marc-cr1810/SoccBot/PCB/KiCAD/Lightsensor/Lightsensor.kicad_pcb

## KiCad design PCB/KiCAD/Lightsensor/Lightsensor.kicad_pcb (2025-05-09)

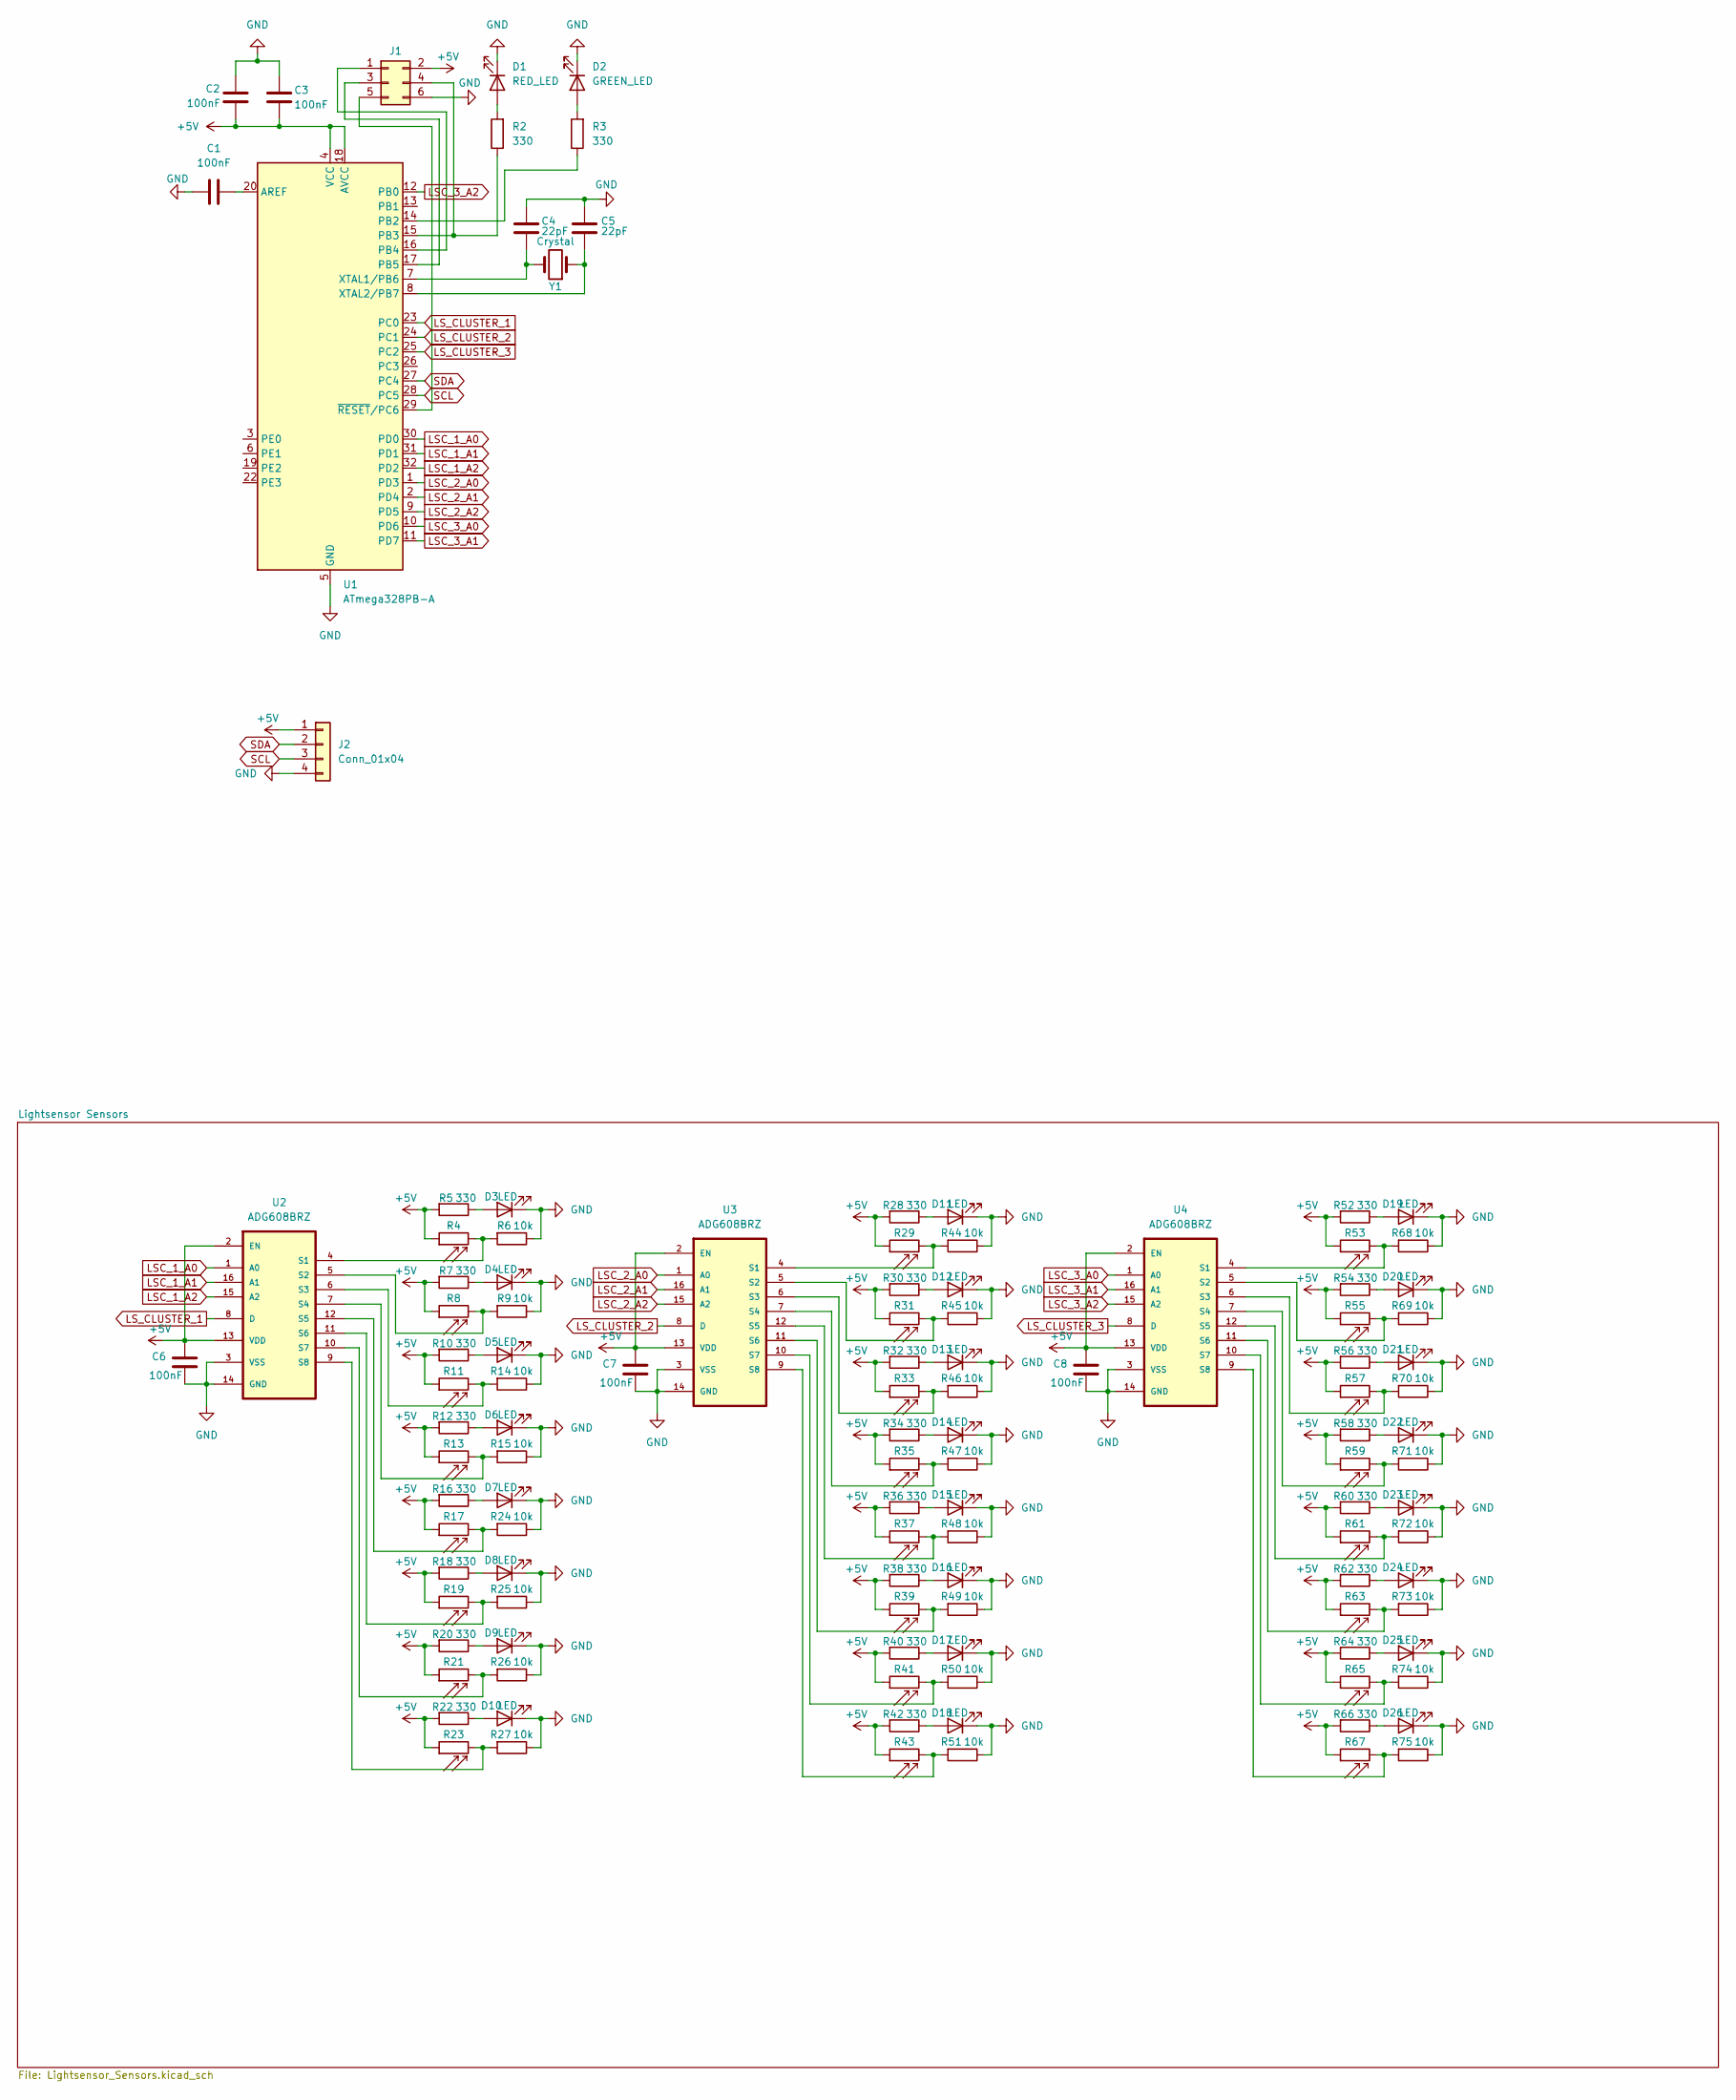
[picture p1: schematic Lightsensor.kicad_sch]

Parts:
C1, C2, C3, C6, C7, C8: 100nF; C_0805_2012Metric_Pad1.18x1.45mm_HandSolder
C4, C5: 22pF; C_0805_2012Metric_Pad1.18x1.45mm_HandSolder
D1: RED_LED; LED_0805_2012Metric_Pad1.15x1.40mm_HandSolder
D2: GREEN_LED; LED_0805_2012Metric_Pad1.15x1.40mm_HandSolder
D3, D4, D5, D6, D7, D8, D9, D10, D11, D12, D13, D14, D15, D16, D17, D18, D19, D20, D21, D22, D23, D24, D25, D26: LED; LED_SMD_3mm
J1: Conn_02x03_Odd_Even; IDC-Header_2x03_P2.54mm_Vertical_SMD
J2: Conn_01x04; JST_PH_B4B-PH-SM4-TB_1x04-1MP_P2.00mm_Vertical
R2, R3, R5, R7, R10, R12, R16, R18, R20, R22, R28, R30, R32, R34, R36, R38, R40, R42, R52, R54, R56, R58, R60, R62, R64, R66: 330; R_0805_2012Metric_Pad1.20x1.40mm_HandSolder
R4, R8, R11, R13, R17, R19, R21, R23, R29, R31, R33, R35, R37, R39, R41, R43, R53, R55, R57, R59, R61, R63, R65, R67: R_Photo; Photoresistor_SMD_5mm
R6, R9, R14, R15, R24, R25, R26, R27, R44, R45, R46, R47, R48, R49, R50, R51, R68, R69, R70, R71, R72, R73, R74, R75: 10k; R_0805_2012Metric_Pad1.20x1.40mm_HandSolder
U1: ATmega328PB-A; TQFP-32_7x7mm_P0.8mm
U2, U3, U4: ADG608BRZ; MPN ADG608BRUZ
Y1: Crystal; Crystal_SMD_HC49-SD

Connections:
+5V: C2.2, C3.2, C6.1, C7.1, C8.1, J1.2, J2.1, R4.1, R5.2, R7.2, R8.1, R10.2, R11.1, R12.2, R13.1, R16.2, R17.1, R18.2, R19.1, R20.2, R21.1, R22.2, R23.1, R28.2, R29.1, R30.2, R31.1, R32.2, R33.1, R34.2, R35.1, R36.2, R37.1, R38.2, R39.1, R40.2, R41.1, R42.2, R43.1, R52.2, R53.1, R54.2, R55.1, R56.2, R57.1, R58.2, R59.1, R60.2, R61.1, R62.2, R63.1, R64.2, R65.1, R66.2, R67.1, U1.4 (VCC), U1.18 (AVCC), U2.2 (EN), U2.13 (VDD), U3.2 (EN), U3.13 (VDD), U4.2 (EN), U4.13 (VDD)
GND: C1.2, C2.1, C3.1, C4.1, C5.1, C6.2, C7.2, C8.2, D1.1 (K), D2.1 (K), D3.1 (K), D4.1 (K), D5.1 (K), D6.1 (K), D7.1 (K), D8.1 (K), D9.1 (K), D10.1 (K), D11.1 (K), D12.1 (K), D13.1 (K), D14.1 (K), D15.1 (K), D16.1 (K), D17.1 (K), D18.1 (K), D19.1 (K), D20.1 (K), D21.1 (K), D22.1 (K), D23.1 (K), D24.1 (K), D25.1 (K), D26.1 (K), J1.6, J2.4, R6.1, R9.1, R14.1, R15.1, R24.1, R25.1, R26.1, R27.1, R44.1, R45.1, R46.1, R47.1, R48.1, R49.1, R50.1, R51.1, R68.1, R69.1, R70.1, R71.1, R72.1, R73.1, R74.1, R75.1, U1.5 (GND), U1.21 (GND), U2.3 (VSS), U2.14 (GND), U3.3 (VSS), U3.14 (GND), U4.3 (VSS), U4.14 (GND)
LSC_1_A0: U1.30 (PD0), U2.1 (A0)
LSC_1_A1: U1.31 (PD1), U2.16 (A1)
LSC_1_A2: U1.32 (PD2), U2.15 (A2)
LSC_2_A0: U1.1 (PD3), U3.1 (A0)
LSC_2_A1: U1.2 (PD4), U3.16 (A1)
LSC_2_A2: U1.9 (PD5), U3.15 (A2)
LSC_3_A0: U1.10 (PD6), U4.1 (A0)
LSC_3_A1: U1.11 (PD7), U4.16 (A1)
LSC_3_A2: U1.12 (PB0), U4.15 (A2)
LS_CLUSTER_1: U1.23 (PC0), U2.8 (D)
LS_CLUSTER_2: U1.24 (PC1), U3.8 (D)
LS_CLUSTER_3: U1.25 (PC2), U4.8 (D)
unnamed: D1.2 (A), R2.2
unnamed: D2.2 (A), R3.2
unnamed: D3.2 (A), R5.1
unnamed: D4.2 (A), R7.1
unnamed: D5.2 (A), R10.1
unnamed: D6.2 (A), R12.1
unnamed: D7.2 (A), R16.1
unnamed: D8.2 (A), R18.1
unnamed: D9.2 (A), R20.1
unnamed: D10.2 (A), R22.1
unnamed: D11.2 (A), R28.1
unnamed: D12.2 (A), R30.1
unnamed: D13.2 (A), R32.1
unnamed: D14.2 (A), R34.1
unnamed: D15.2 (A), R36.1
unnamed: D16.2 (A), R38.1
unnamed: D17.2 (A), R40.1
unnamed: D18.2 (A), R42.1
unnamed: D19.2 (A), R52.1
unnamed: D20.2 (A), R54.1
unnamed: D21.2 (A), R56.1
unnamed: D22.2 (A), R58.1
unnamed: D23.2 (A), R60.1
unnamed: D24.2 (A), R62.1
unnamed: D25.2 (A), R64.1
unnamed: D26.2 (A), R66.1
unnamed: J1.1, U1.16 (PB4)
unnamed: J1.3, U1.17 (PB5)
unnamed: J1.4, R2.1, U1.15 (PB3)
unnamed: J1.5, U1.29 (~RESET/PC6)
unnamed: C1.1, U1.20 (AREF)
unnamed: R3.1, U1.14 (PB2)
unnamed: C4.2, U1.7 (XTAL1/PB6), Y1.2
unnamed: C5.2, U1.8 (XTAL2/PB7), Y1.1
unnamed: R4.2, R6.2, U2.4 (S1)
unnamed: R8.2, R9.2, U2.5 (S2)
unnamed: R11.2, R14.2, U2.6 (S3)
unnamed: R13.2, R15.2, U2.7 (S4)
unnamed: R17.2, R24.2, U2.12 (S5)
unnamed: R19.2, R25.2, U2.11 (S6)
unnamed: R21.2, R26.2, U2.10 (S7)
unnamed: R23.2, R27.2, U2.9 (S8)
unnamed: R29.2, R44.2, U3.4 (S1)
unnamed: R31.2, R45.2, U3.5 (S2)
unnamed: R33.2, R46.2, U3.6 (S3)
unnamed: R35.2, R47.2, U3.7 (S4)
unnamed: R37.2, R48.2, U3.12 (S5)
unnamed: R39.2, R49.2, U3.11 (S6)
unnamed: R41.2, R50.2, U3.10 (S7)
unnamed: R43.2, R51.2, U3.9 (S8)
unnamed: R53.2, R68.2, U4.4 (S1)
unnamed: R55.2, R69.2, U4.5 (S2)
unnamed: R57.2, R70.2, U4.6 (S3)
unnamed: R59.2, R71.2, U4.7 (S4)
unnamed: R61.2, R72.2, U4.12 (S5)
unnamed: R63.2, R73.2, U4.11 (S6)
unnamed: R65.2, R74.2, U4.10 (S7)
unnamed: R67.2, R75.2, U4.9 (S8)
SCL: J2.3, U1.28 (PC5)
SDA: J2.2, U1.27 (PC4)

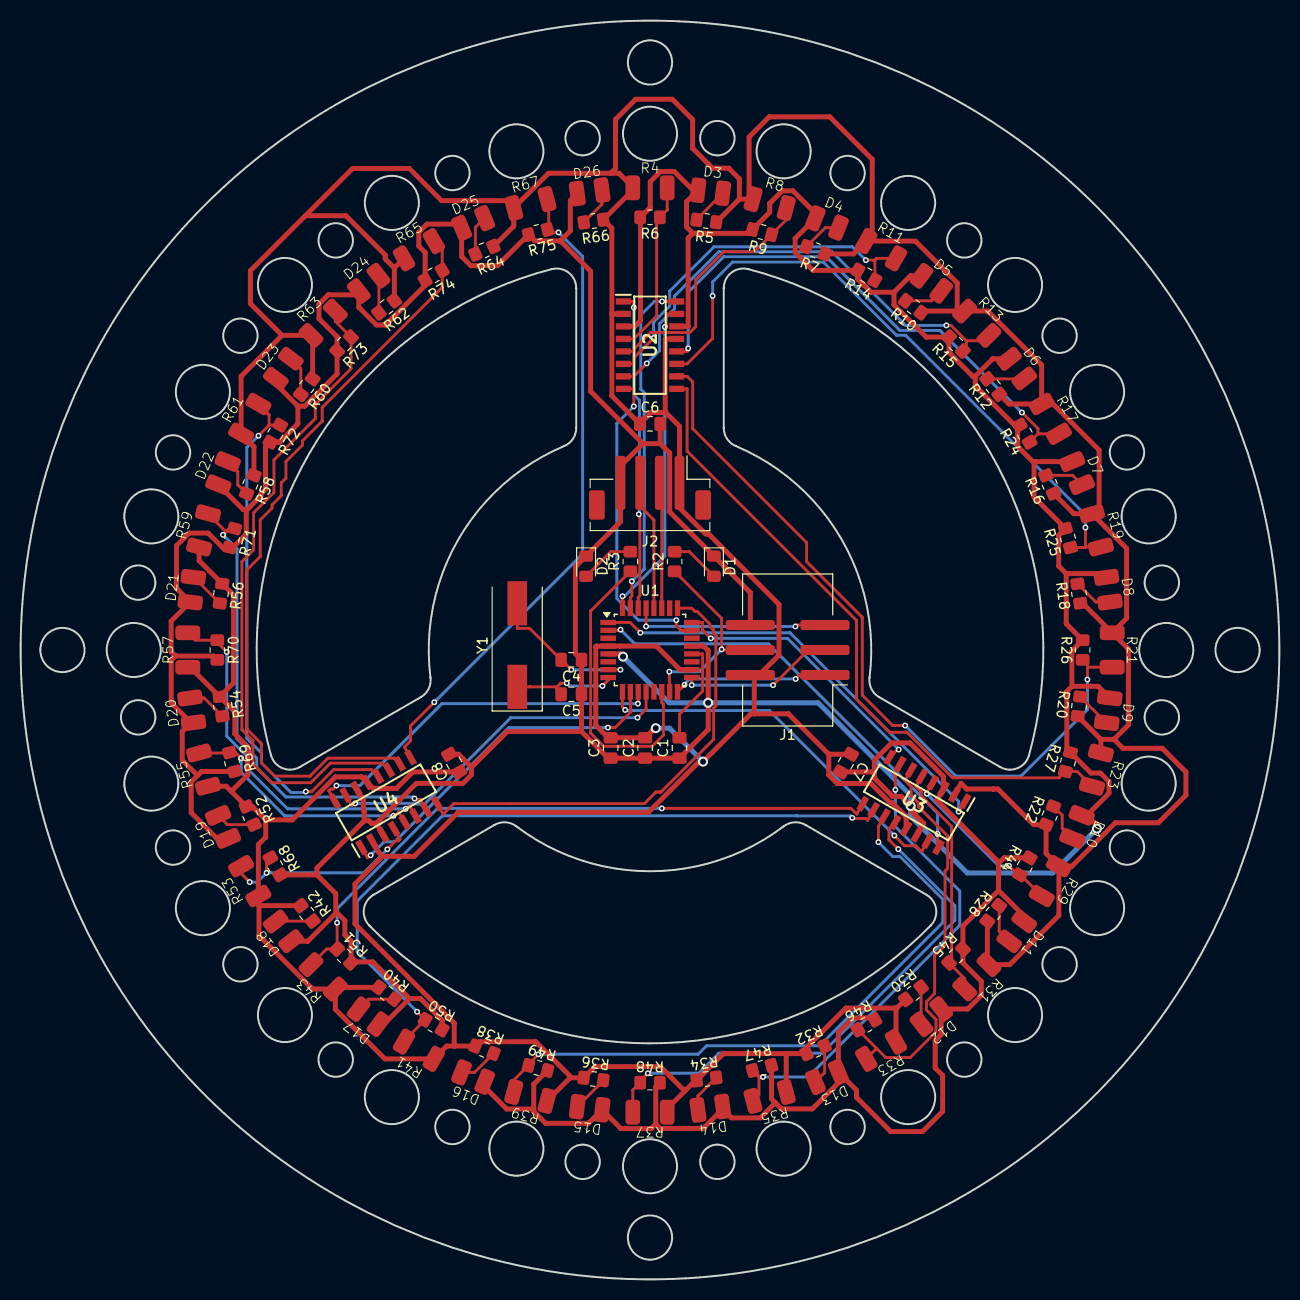
[picture p2: board Lightsensor.kicad_pcb from above]

Board: 2 copper layers, 128.0 x 128.0 mm, 115 parts (0 on the bottom side), 74 nets.
