marc-cr1810/SoccBot/PCB/KiCAD/Main (Teensy)/Main (Teensy).kicad_pcb

## KiCad design PCB/KiCAD/Main (Teensy)/Main (Teensy).kicad_pcb (2025-05-09)

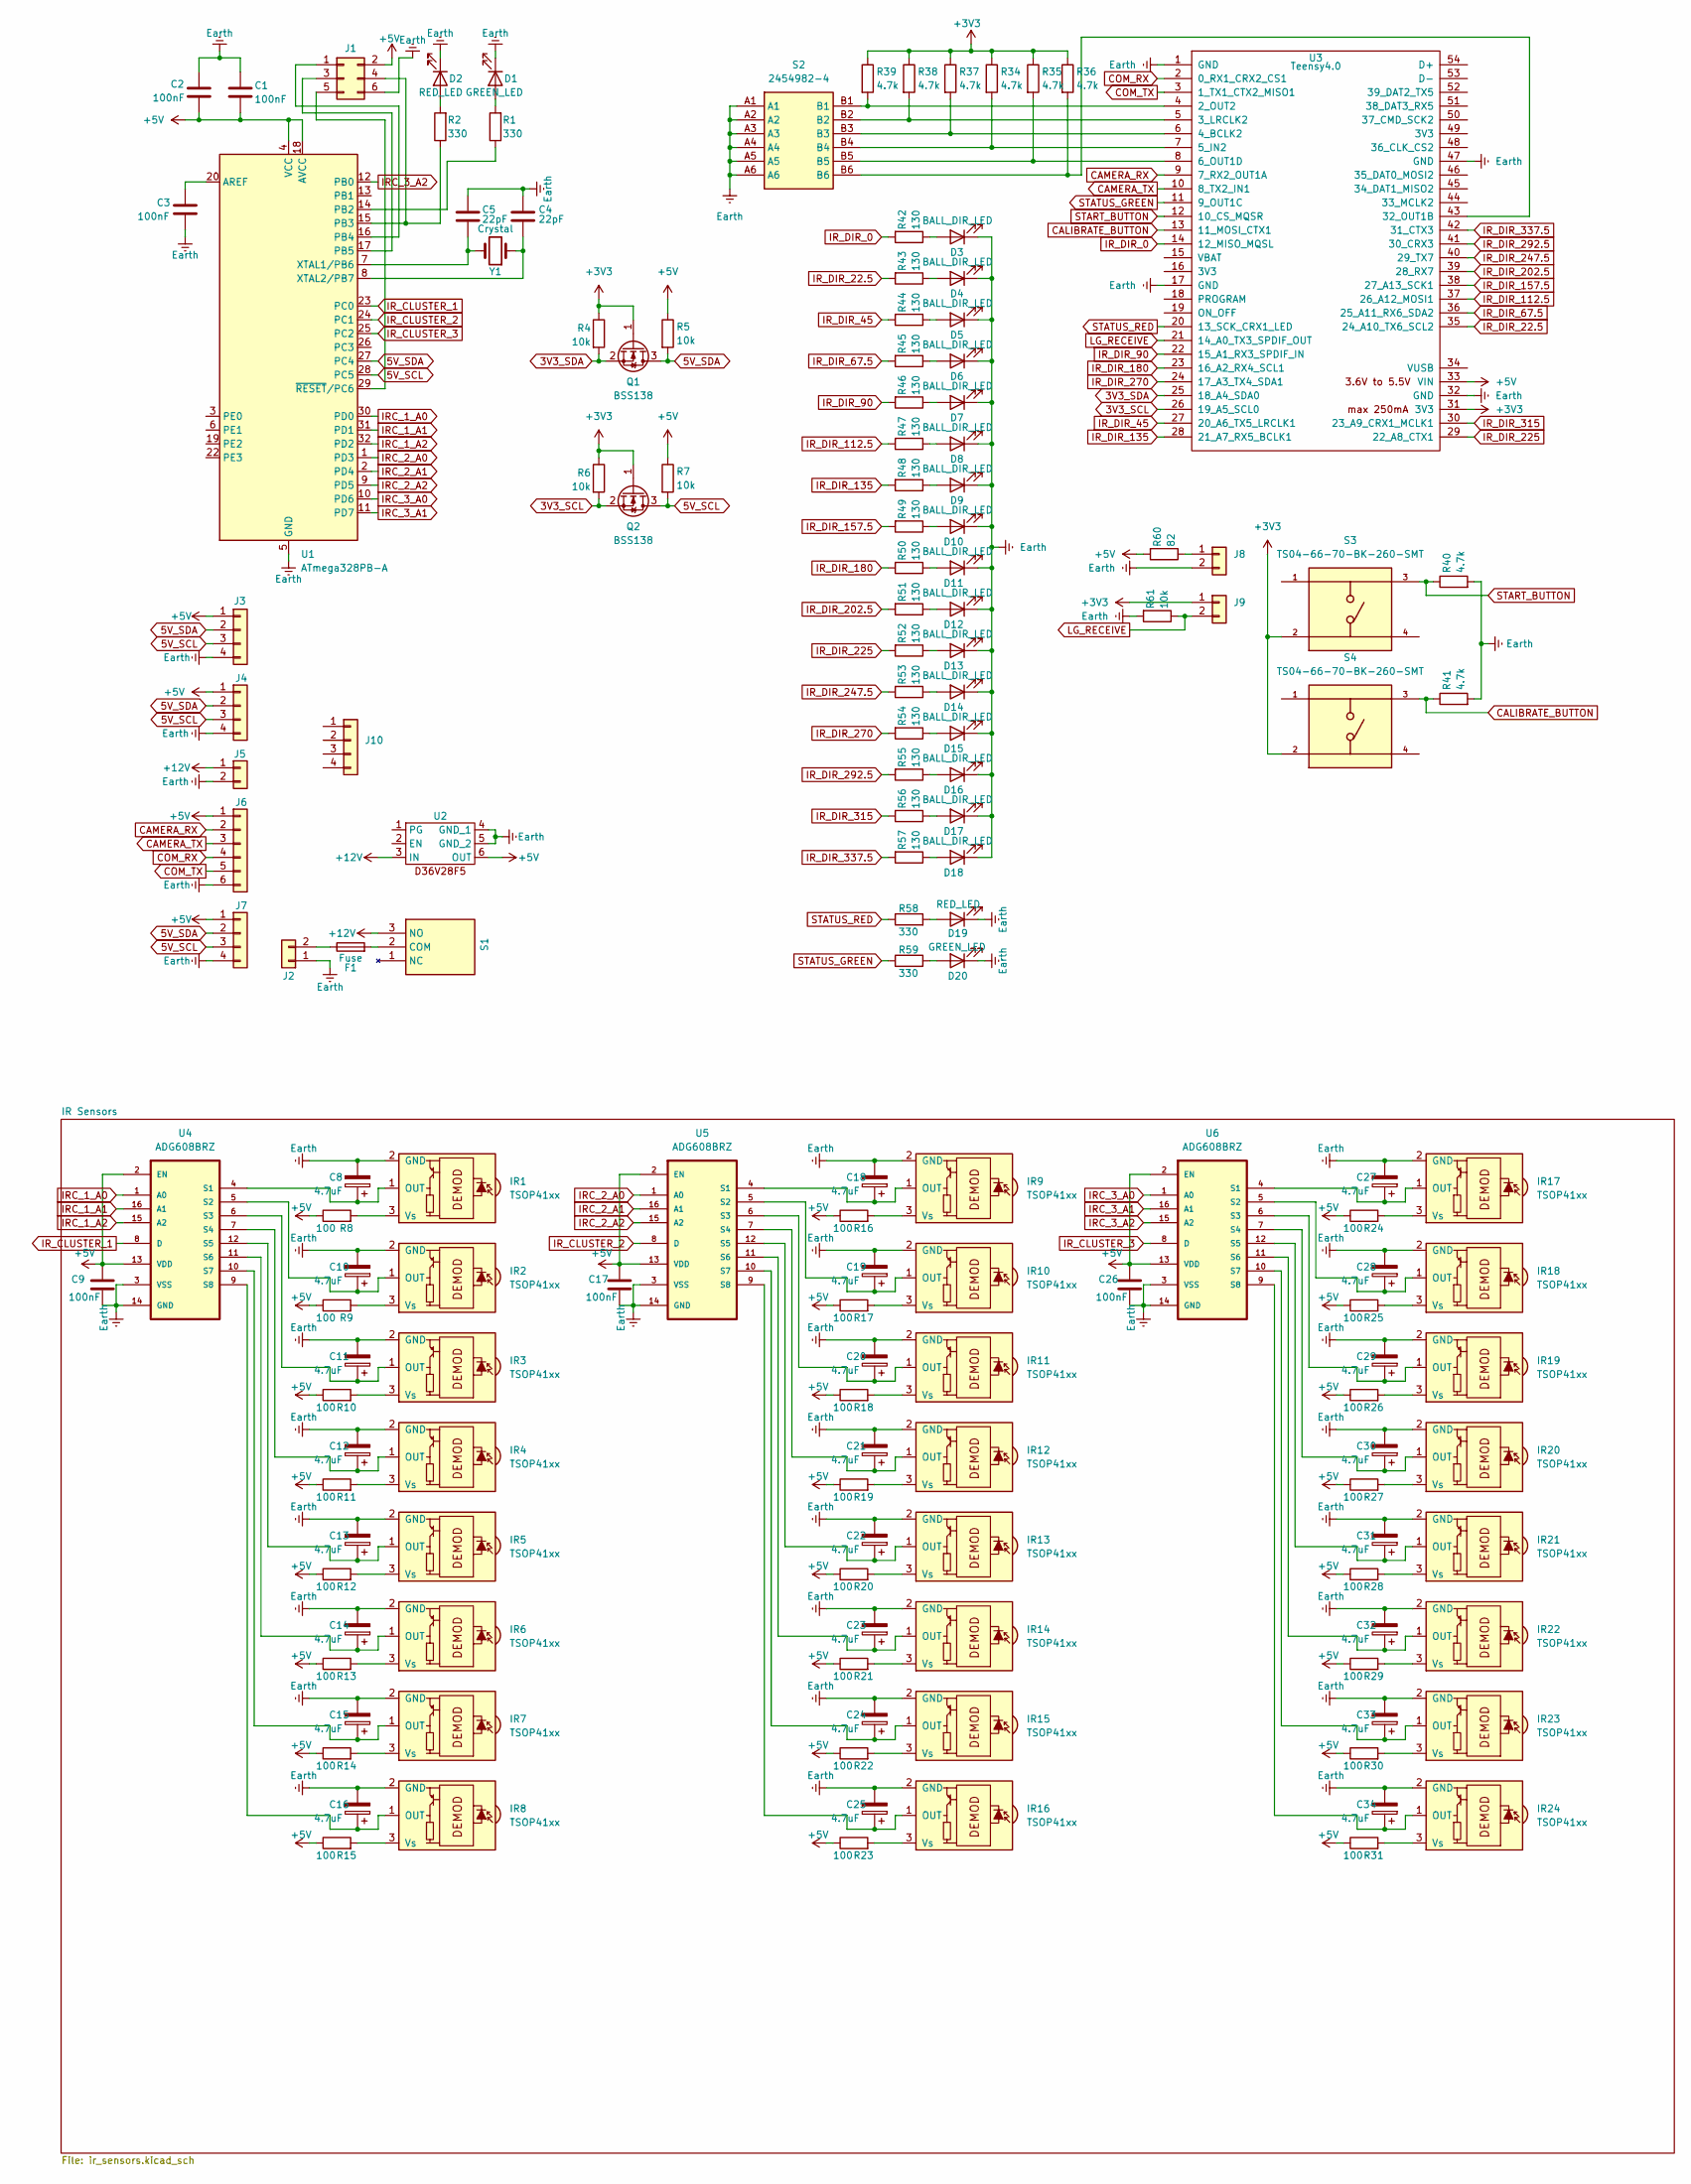
[picture p3: schematic Main (Teensy).kicad_sch]

Parts:
C1, C2, C3, C9, C17, C26: 100nF; C_0805_2012Metric_Pad1.18x1.45mm_HandSolder
C4, C5: 22pF; C_0805_2012Metric_Pad1.18x1.45mm_HandSolder
C8, C10, C11, C12, C13, C14, C15, C16, C18, C19, C20, C21, C22, C23, C24, C25, C27, C28, C29, C30, C31, C32, C33, C34: 4.7uF; CP_Radial_D5.0mm_P2.00mm
D1, D20: GREEN_LED; LED_0805_2012Metric_Pad1.15x1.40mm_HandSolder
D2, D19: RED_LED; LED_0805_2012Metric_Pad1.15x1.40mm_HandSolder
D3, D4, D5, D6, D7, D8, D9, D10, D11, D12, D13, D14, D15, D16, D17, D18: BALL_DIR_LED; LED_0805_2012Metric_Pad1.15x1.40mm_HandSolder
F1: Fuse; Fuseholder_Blade_Mini_Keystone_3568
IR1, IR2, IR3, IR4, IR5, IR6, IR7, IR8, IR9, IR10, IR11, IR12, IR13, IR14, IR15, IR16, IR17, IR18, IR19, IR20, IR21, IR22, IR23, IR24: TSOP41xx; Vishay_CUSTOM-3Pin
J1: Conn_02x03_Odd_Even; IDC-Header_2x03_P2.54mm_Vertical_SMD
J2: Conn_01x02; AMASS_XT60-M_1x02_P7.20mm_Vertical
J3, J4, J7: Conn_01x04; JST_PH_B4B-PH-K_1x04_P2.00mm_Vertical
J5: Conn_01x02; Molex_KK-254_AE-6410-02A_1x02_P2.54mm_Vertical
J6: Conn_01x06; JST_PH_B6B-PH-K_1x06_P2.00mm_Vertical
J8, J9: Conn_01x02; JST_PH_B2B-PH-K_1x02_P2.00mm_Vertical
J10: Conn_01x04; JST_XH_B4B-XH-A_1x04_P2.50mm_Vertical
Q1, Q2: BSS138; SOT-23
R1, R2, R58, R59: 330; R_0805_2012Metric_Pad1.20x1.40mm_HandSolder
R4, R5, R6, R7, R61: 10k; R_0805_2012Metric_Pad1.20x1.40mm_HandSolder
R8, R9, R10, R11, R12, R13, R14, R15, R16, R17, R18, R19, R20, R21, R22, R23, R24, R25, R26, R27, R28, R29, R30, R31: 100; R_0805_2012Metric_Pad1.20x1.40mm_HandSolder
R34, R35, R36, R37, R38, R39, R40, R41: 4.7k; R_0805_2012Metric_Pad1.20x1.40mm_HandSolder
R42, R43, R44, R45, R46, R47, R48, R49, R50, R51, R52, R53, R54, R55, R56, R57: 130; R_0805_2012Metric_Pad1.20x1.40mm_HandSolder
R60: 82; R_0805_2012Metric_Pad1.20x1.40mm_HandSolder
S1: 1101M2S3CGE2; Mouser Part Number 611-1101M2S3CGE2
S2: 2454982-4; DIP_6_SWITCH_THT; Mouser Part Number 655-2454982-4
S3, S4: TS04-66-70-BK-260-SMT; SW_TS04-66-70-BK-260-SMT; PARTREV 1.0
U1: ATmega328PB-A; TQFP-32_7x7mm_P0.8mm
U2: D36V28F5
U3: Teensy4.0; Teensy40
U4, U5, U6: ADG608BRZ; MPN ADG608BRUZ
Y1: Crystal; Crystal_SMD_HC49-SD

Connections:
3V3_SCL: Q2.2 (S), R6.2, U3.26 (19_A5_SCL0)
3V3_SDA: Q1.2 (S), R4.2, U3.25 (18_A4_SDA0)
5V_SCL: J3.3, J4.3, J7.3, Q2.3 (D), R7.2, U1.28 (PC5)
5V_SDA: J3.2, J4.2, J7.2, Q1.3 (D), R5.2, U1.27 (PC4)
+3V3: J9.1, Q1.1 (G), Q2.1 (G), R4.1, R6.1, R34.1, R35.1, R36.1, R37.1, R38.1, R39.1, S3.2, S4.2, U3.31 (3V3)
+5V: C1.2, C2.2, C9.1, C17.1, C26.1, J1.2, J3.1, J4.1, J6.1, J7.1, R5.1, R7.1, R8.1, R9.1, R10.1, R11.1, R12.1, R13.1, R14.1, R15.1, R16.1, R17.1, R18.1, R19.1, R20.1, R21.1, R22.1, R23.1, R24.1, R25.1, R26.1, R27.1, R28.1, R29.1, R30.1, R31.1, R60.2, U1.4 (VCC), U1.18 (AVCC), U2.6 (OUT), U3.33 (VIN), U4.2 (EN), U4.13 (VDD), U5.2 (EN), U5.13 (VDD), U6.2 (EN), U6.13 (VDD)
+12V: J5.1, S1.3 (NO), U2.3 (IN)
CALIBRATE_BUTTON: R41.1, S4.3, U3.13 (11_MOSI_CTX1)
CAMERA_RX: J6.2, U3.9 (7_RX2_OUT1A)
CAMERA_TX: J6.3, U3.10 (8_TX2_IN1)
COM_RX: J6.4, U3.2 (0_RX1_CRX2_CS1)
COM_TX: J6.5, U3.3 (1_TX1_CTX2_MISO1)
Earth: C1.1, C2.1, C3.2, C4.1, C5.1, C8.2, C9.2, C10.2, C11.2, C12.2, C13.2, C14.2, C15.2, C16.2, C17.2, C18.2, C19.2, C20.2, C21.2, C22.2, C23.2, C24.2, C25.2, C26.2, C27.2, C28.2, C29.2, C30.2, C31.2, C32.2, C33.2, C34.2, D1.1 (K), D2.1 (K), D3.1 (K), D4.1 (K), D5.1 (K), D6.1 (K), D7.1 (K), D8.1 (K), D9.1 (K), D10.1 (K), D11.1 (K), D12.1 (K), D13.1 (K), D14.1 (K), D15.1 (K), D16.1 (K), D17.1 (K), D18.1 (K), D19.1 (K), D20.1 (K), IR1.2 (GND), IR2.2 (GND), IR3.2 (GND), IR4.2 (GND), IR5.2 (GND), IR6.2 (GND), IR7.2 (GND), IR8.2 (GND), IR9.2 (GND), IR10.2 (GND), IR11.2 (GND), IR12.2 (GND), IR13.2 (GND), IR14.2 (GND), IR15.2 (GND), IR16.2 (GND), IR17.2 (GND), IR18.2 (GND), IR19.2 (GND), IR20.2 (GND), IR21.2 (GND), IR22.2 (GND), IR23.2 (GND), IR24.2 (GND), J1.6, J2.1, J3.4, J4.4, J5.2, J6.6, J7.4, J8.2, R40.2, R41.2, R61.2, S2.A1, S2.A2, S2.A3, S2.A4, S2.A5, S2.A6, U1.5 (GND), U1.21 (GND), U2.4 (GND_1), U2.5 (GND_2), U3.1 (GND), U3.17 (GND), U3.32 (GND), U3.47 (GND), U4.3 (VSS), U4.14 (GND), U5.3 (VSS), U5.14 (GND), U6.3 (VSS), U6.14 (GND)
IRC_1_A0: U1.30 (PD0), U4.1 (A0)
IRC_1_A1: U1.31 (PD1), U4.16 (A1)
IRC_1_A2: U1.32 (PD2), U4.15 (A2)
IRC_2_A0: U1.1 (PD3), U5.1 (A0)
IRC_2_A1: U1.2 (PD4), U5.16 (A1)
IRC_2_A2: U1.9 (PD5), U5.15 (A2)
IRC_3_A0: U1.10 (PD6), U6.1 (A0)
IRC_3_A1: U1.11 (PD7), U6.16 (A1)
IRC_3_A2: U1.12 (PB0), U6.15 (A2)
IR_CLUSTER_1: U1.23 (PC0), U4.8 (D)
IR_CLUSTER_2: U1.24 (PC1), U5.8 (D)
IR_CLUSTER_3: U1.25 (PC2), U6.8 (D)
IR_DIR_0: R42.2, U3.14 (12_MISO_MQSL)
IR_DIR_22.5: R43.2, U3.35 (24_A10_TX6_SCL2)
IR_DIR_45: R44.2, U3.27 (20_A6_TX5_LRCLK1)
IR_DIR_67.5: R45.2, U3.36 (25_A11_RX6_SDA2)
IR_DIR_90: R46.2, U3.22 (15_A1_RX3_SPDIF_IN)
IR_DIR_112.5: R47.2, U3.37 (26_A12_MOSI1)
IR_DIR_135: R48.2, U3.28 (21_A7_RX5_BCLK1)
IR_DIR_157.5: R49.2, U3.38 (27_A13_SCK1)
IR_DIR_180: R50.2, U3.23 (16_A2_RX4_SCL1)
IR_DIR_202.5: R51.2, U3.39 (28_RX7)
IR_DIR_225: R52.2, U3.29 (22_A8_CTX1)
IR_DIR_247.5: R53.2, U3.40 (29_TX7)
IR_DIR_270: R54.2, U3.24 (17_A3_TX4_SDA1)
IR_DIR_292.5: R55.2, U3.41 (30_CRX3)
IR_DIR_315: R56.2, U3.30 (23_A9_CRX1_MCLK1)
IR_DIR_337.5: R57.2, U3.42 (31_CTX3)
LG_RECEIVE: J9.2, R61.1, U3.21 (14_A0_TX3_SPDIF_OUT)
unnamed: D1.2 (A), R1.2
unnamed: D2.2 (A), R2.2
unnamed: D3.2 (A), R42.1
unnamed: D4.2 (A), R43.1
unnamed: D5.2 (A), R44.1
unnamed: D6.2 (A), R45.1
unnamed: D7.2 (A), R46.1
unnamed: D8.2 (A), R47.1
unnamed: D9.2 (A), R48.1
unnamed: D10.2 (A), R49.1
unnamed: D11.2 (A), R50.1
unnamed: D12.2 (A), R51.1
unnamed: D13.2 (A), R52.1
unnamed: D14.2 (A), R53.1
unnamed: D15.2 (A), R54.1
unnamed: D16.2 (A), R55.1
unnamed: D17.2 (A), R56.1
unnamed: D18.2 (A), R57.1
unnamed: D19.2 (A), R58.2
unnamed: D20.2 (A), R59.2
unnamed: C8.1, IR1.1 (OUT), U4.4 (S1)
unnamed: IR1.3 (Vs), R8.2
unnamed: C10.1, IR2.1 (OUT), U4.5 (S2)
unnamed: IR2.3 (Vs), R9.2
unnamed: C11.1, IR3.1 (OUT), U4.6 (S3)
unnamed: IR3.3 (Vs), R10.2
unnamed: C12.1, IR4.1 (OUT), U4.7 (S4)
unnamed: IR4.3 (Vs), R11.2
unnamed: C13.1, IR5.1 (OUT), U4.12 (S5)
unnamed: IR5.3 (Vs), R12.2
unnamed: C14.1, IR6.1 (OUT), U4.11 (S6)
unnamed: IR6.3 (Vs), R13.2
unnamed: C15.1, IR7.1 (OUT), U4.10 (S7)
unnamed: IR7.3 (Vs), R14.2
unnamed: C16.1, IR8.1 (OUT), U4.9 (S8)
unnamed: IR8.3 (Vs), R15.2
unnamed: C18.1, IR9.1 (OUT), U5.4 (S1)
unnamed: IR9.3 (Vs), R16.2
unnamed: C19.1, IR10.1 (OUT), U5.5 (S2)
unnamed: IR10.3 (Vs), R17.2
unnamed: C20.1, IR11.1 (OUT), U5.6 (S3)
unnamed: IR11.3 (Vs), R18.2
unnamed: C21.1, IR12.1 (OUT), U5.7 (S4)
unnamed: IR12.3 (Vs), R19.2
unnamed: C22.1, IR13.1 (OUT), U5.12 (S5)
unnamed: IR13.3 (Vs), R20.2
unnamed: C23.1, IR14.1 (OUT), U5.11 (S6)
unnamed: IR14.3 (Vs), R21.2
unnamed: C24.1, IR15.1 (OUT), U5.10 (S7)
unnamed: IR15.3 (Vs), R22.2
unnamed: C25.1, IR16.1 (OUT), U5.9 (S8)
unnamed: IR16.3 (Vs), R23.2
unnamed: C27.1, IR17.1 (OUT), U6.4 (S1)
unnamed: IR17.3 (Vs), R24.2
unnamed: C28.1, IR18.1 (OUT), U6.5 (S2)
unnamed: IR18.3 (Vs), R25.2
unnamed: C29.1, IR19.1 (OUT), U6.6 (S3)
unnamed: IR19.3 (Vs), R26.2
unnamed: C30.1, IR20.1 (OUT), U6.7 (S4)
unnamed: IR20.3 (Vs), R27.2
unnamed: C31.1, IR21.1 (OUT), U6.12 (S5)
unnamed: IR21.3 (Vs), R28.2
unnamed: C32.1, IR22.1 (OUT), U6.11 (S6)
unnamed: IR22.3 (Vs), R29.2
unnamed: C33.1, IR23.1 (OUT), U6.10 (S7)
unnamed: IR23.3 (Vs), R30.2
unnamed: C34.1, IR24.1 (OUT), U6.9 (S8)
unnamed: IR24.3 (Vs), R31.2
unnamed: J1.1, U1.16 (PB4)
unnamed: J1.3, U1.17 (PB5)
unnamed: J1.4, R2.1, U1.15 (PB3)
unnamed: J1.5, U1.29 (~RESET/PC6)
unnamed: F1.1, J2.2
unnamed: J8.1, R60.1
unnamed: F1.2, S1.2 (COM)
unnamed: C3.1, U1.20 (AREF)
unnamed: R1.1, U1.14 (PB2)
unnamed: C5.2, U1.7 (XTAL1/PB6), Y1.2
unnamed: C4.2, U1.8 (XTAL2/PB7), Y1.1
unnamed: R39.2, S2.B1, U3.4 (2_OUT2)
unnamed: R38.2, S2.B2, U3.5 (3_LRCLK2)
unnamed: R37.2, S2.B3, U3.6 (4_BCLK2)
unnamed: R34.2, S2.B4, U3.7 (5_IN2)
unnamed: R35.2, S2.B5, U3.8 (6_OUT1D)
unnamed: R36.2, S2.B6, U3.43 (32_OUT1B)
START_BUTTON: R40.1, S3.3, U3.12 (10_CS_MQSR)
STATUS_GREEN: R59.1, U3.11 (9_OUT1C)
STATUS_RED: R58.1, U3.20 (13_SCK_CRX1_LED)

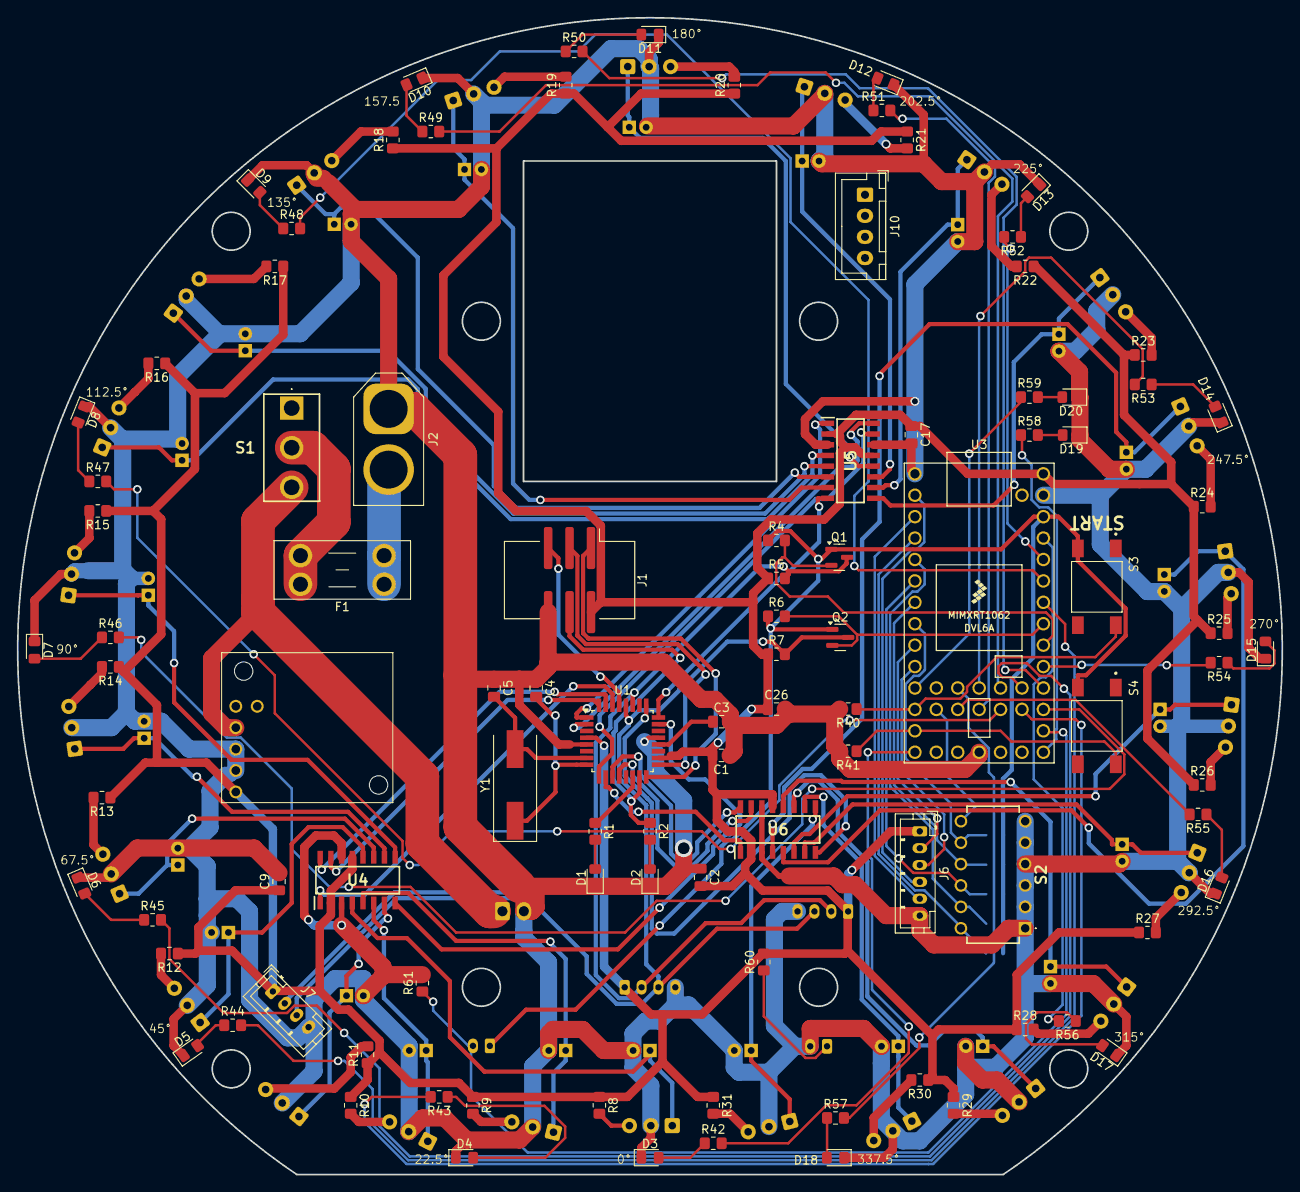
[picture p4: board Main (Teensy).kicad_pcb from above]

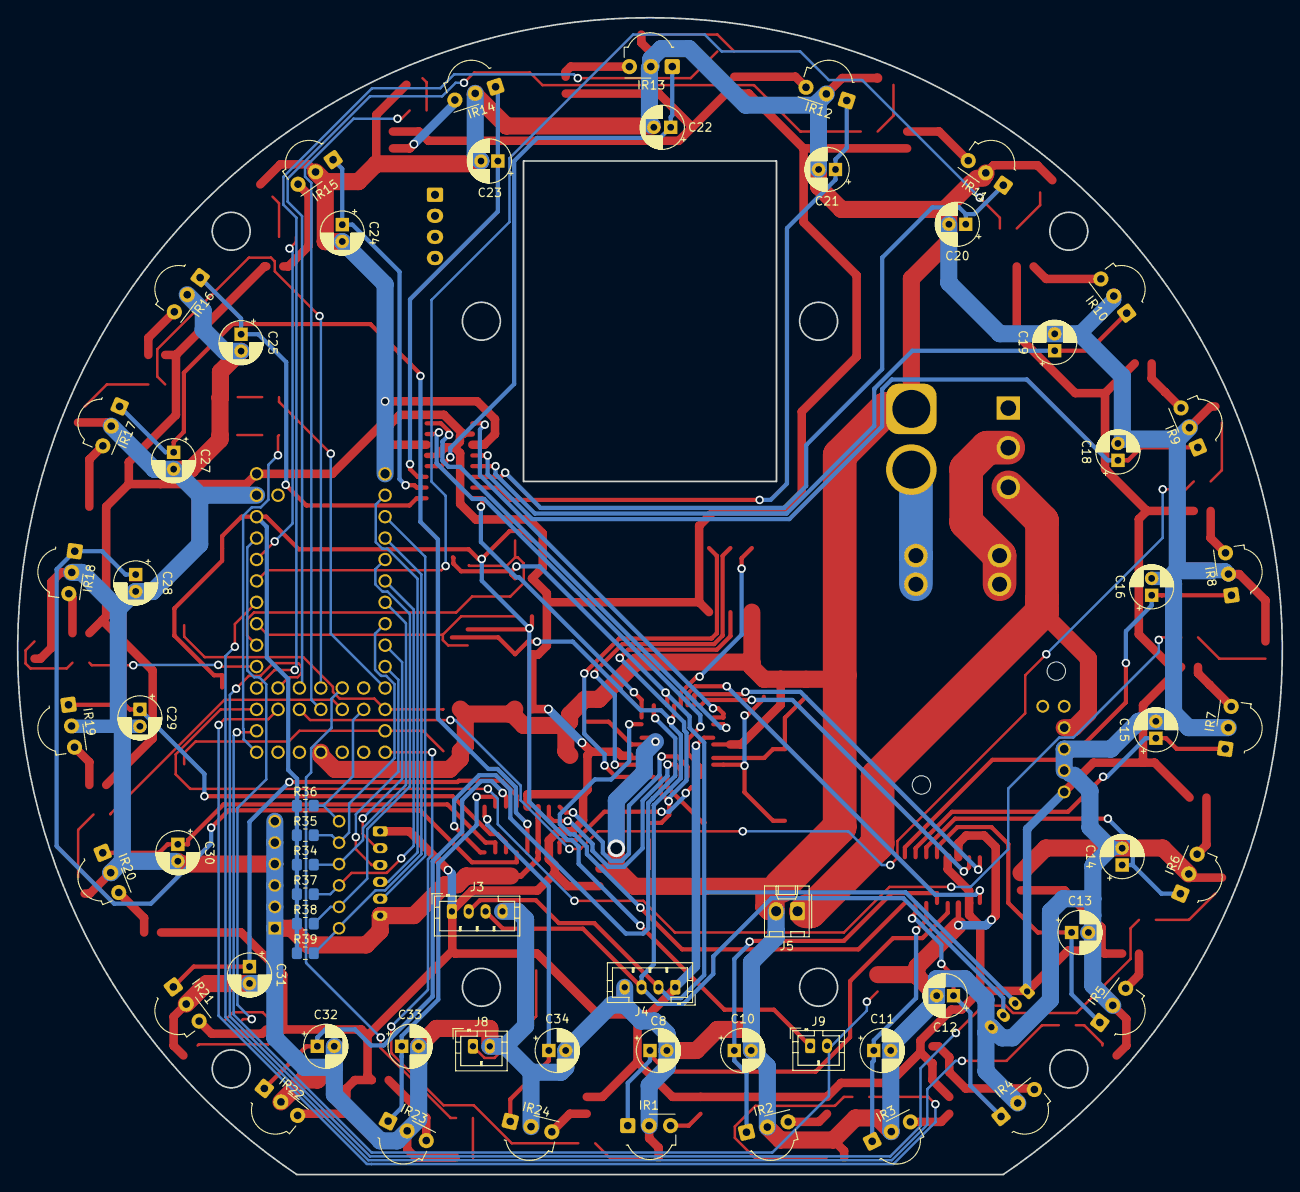
[picture p5: board Main (Teensy).kicad_pcb from below]

Board: 2 copper layers, 150.0 x 137.2 mm, 158 parts (59 on the bottom side), 130 nets.
