marc-cr1810/SoccBot/PCB/KiCAD/Camera/Camera.kicad_pcb

## KiCad design PCB/KiCAD/Camera/Camera.kicad_pcb (2025-05-09)

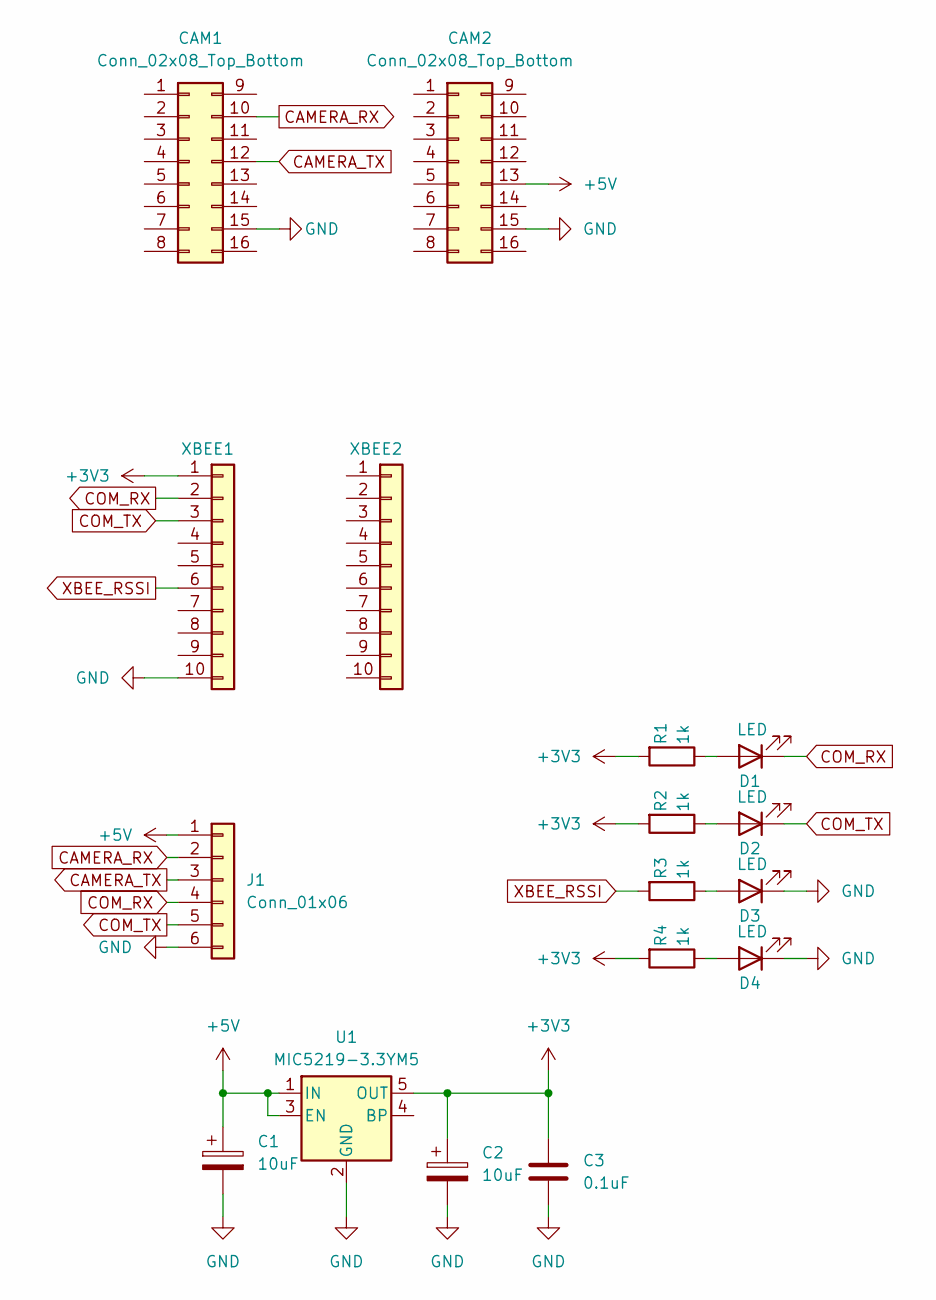
[picture p6: schematic Camera.kicad_sch]

Parts:
C1, C2: 10uF; CP_EIA-3216-12_Kemet-S_Pad1.58x1.35mm_HandSolder
C3: 0.1uF; C_0805_2012Metric_Pad1.18x1.45mm_HandSolder
CAM1, CAM2: Conn_02x08_Top_Bottom; PinSocket_2x08_P2.54mm_Vertical
D1, D2, D3, D4: LED; LED_0805_2012Metric_Pad1.15x1.40mm_HandSolder
J1: Conn_01x06; JST_PH_B6B-PH-K_1x06_P2.00mm_Vertical
R1, R2, R3, R4: 1k; R_0805_2012Metric_Pad1.20x1.40mm_HandSolder
U1: MIC5219-3.3YM5; SOT-23-5
XBEE1, XBEE2: Conn_01x10; PinSocket_1x10_P2.00mm_Vertical

Connections:
+3V3: C2.1, C3.1, R1.2, R2.2, R4.2, U1.5 (OUT), XBEE1.1
+5V: C1.1, CAM2.13, J1.1, U1.1 (IN), U1.3 (EN)
CAMERA_RX: CAM1.10, J1.2
CAMERA_TX: CAM1.12, J1.3
COM_RX: D1.1 (K), J1.4, XBEE1.2
COM_TX: D2.1 (K), J1.5, XBEE1.3
GND: C1.2, C2.2, C3.2, CAM1.15, CAM2.15, D3.1 (K), D4.1 (K), J1.6, U1.2 (GND), XBEE1.10
unnamed: D1.2 (A), R1.1
unnamed: D2.2 (A), R2.1
unnamed: D3.2 (A), R3.1
unnamed: D4.2 (A), R4.1
XBEE_RSSI: R3.2, XBEE1.6
