marc-cr1810/SoccBot/PCB/KiCAD/Camera/Camera.kicad_pcb

## KiCad design PCB/KiCAD/Camera/Camera.kicad_pcb (continued)

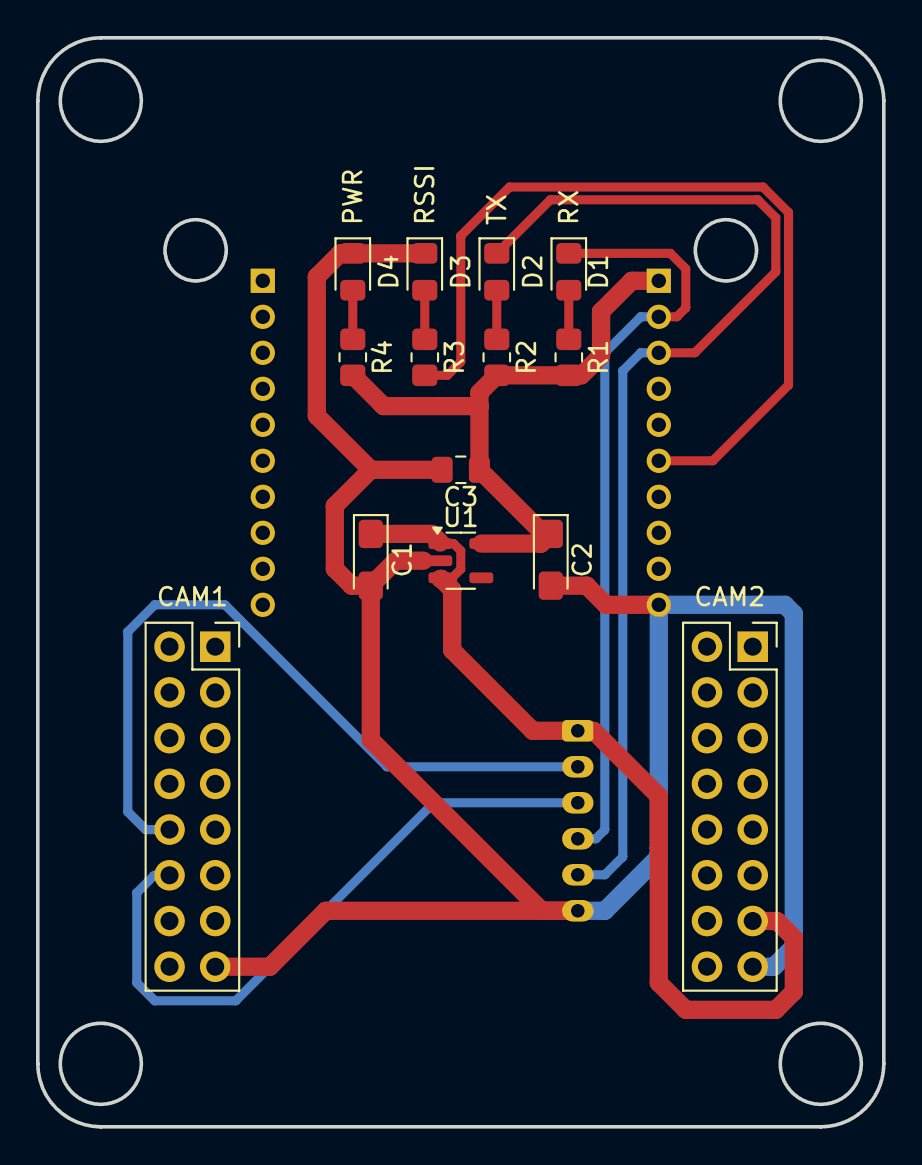
[picture p7: board Camera.kicad_pcb from above]

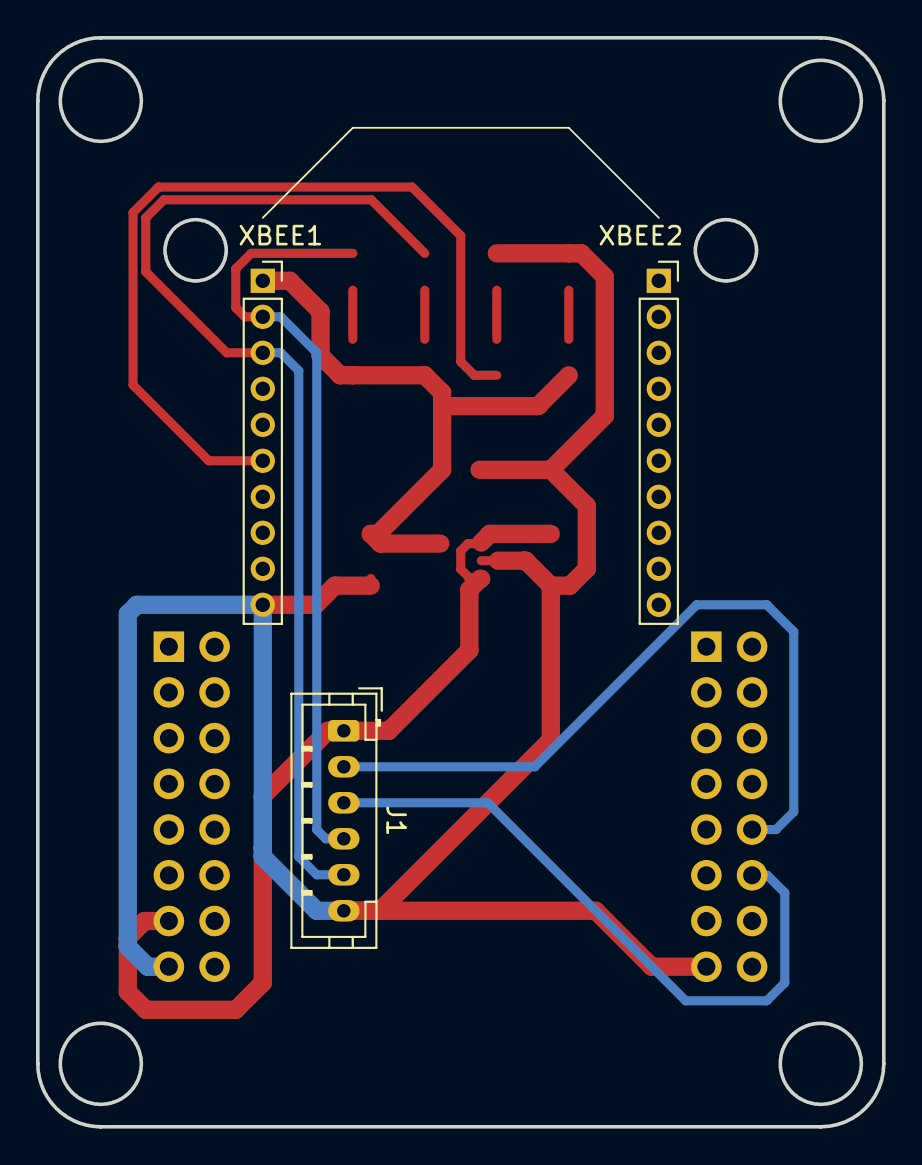
[picture p8: board Camera.kicad_pcb from below]

Board: 2 copper layers, 47.0 x 60.5 mm, 17 parts (3 on the bottom side), 12 nets.
