marc-cr1810/SoccBot/PCB/KiCAD/Motor/Motor.kicad_pcb

## KiCad design PCB/KiCAD/Motor/Motor.kicad_pcb (2025-05-09)

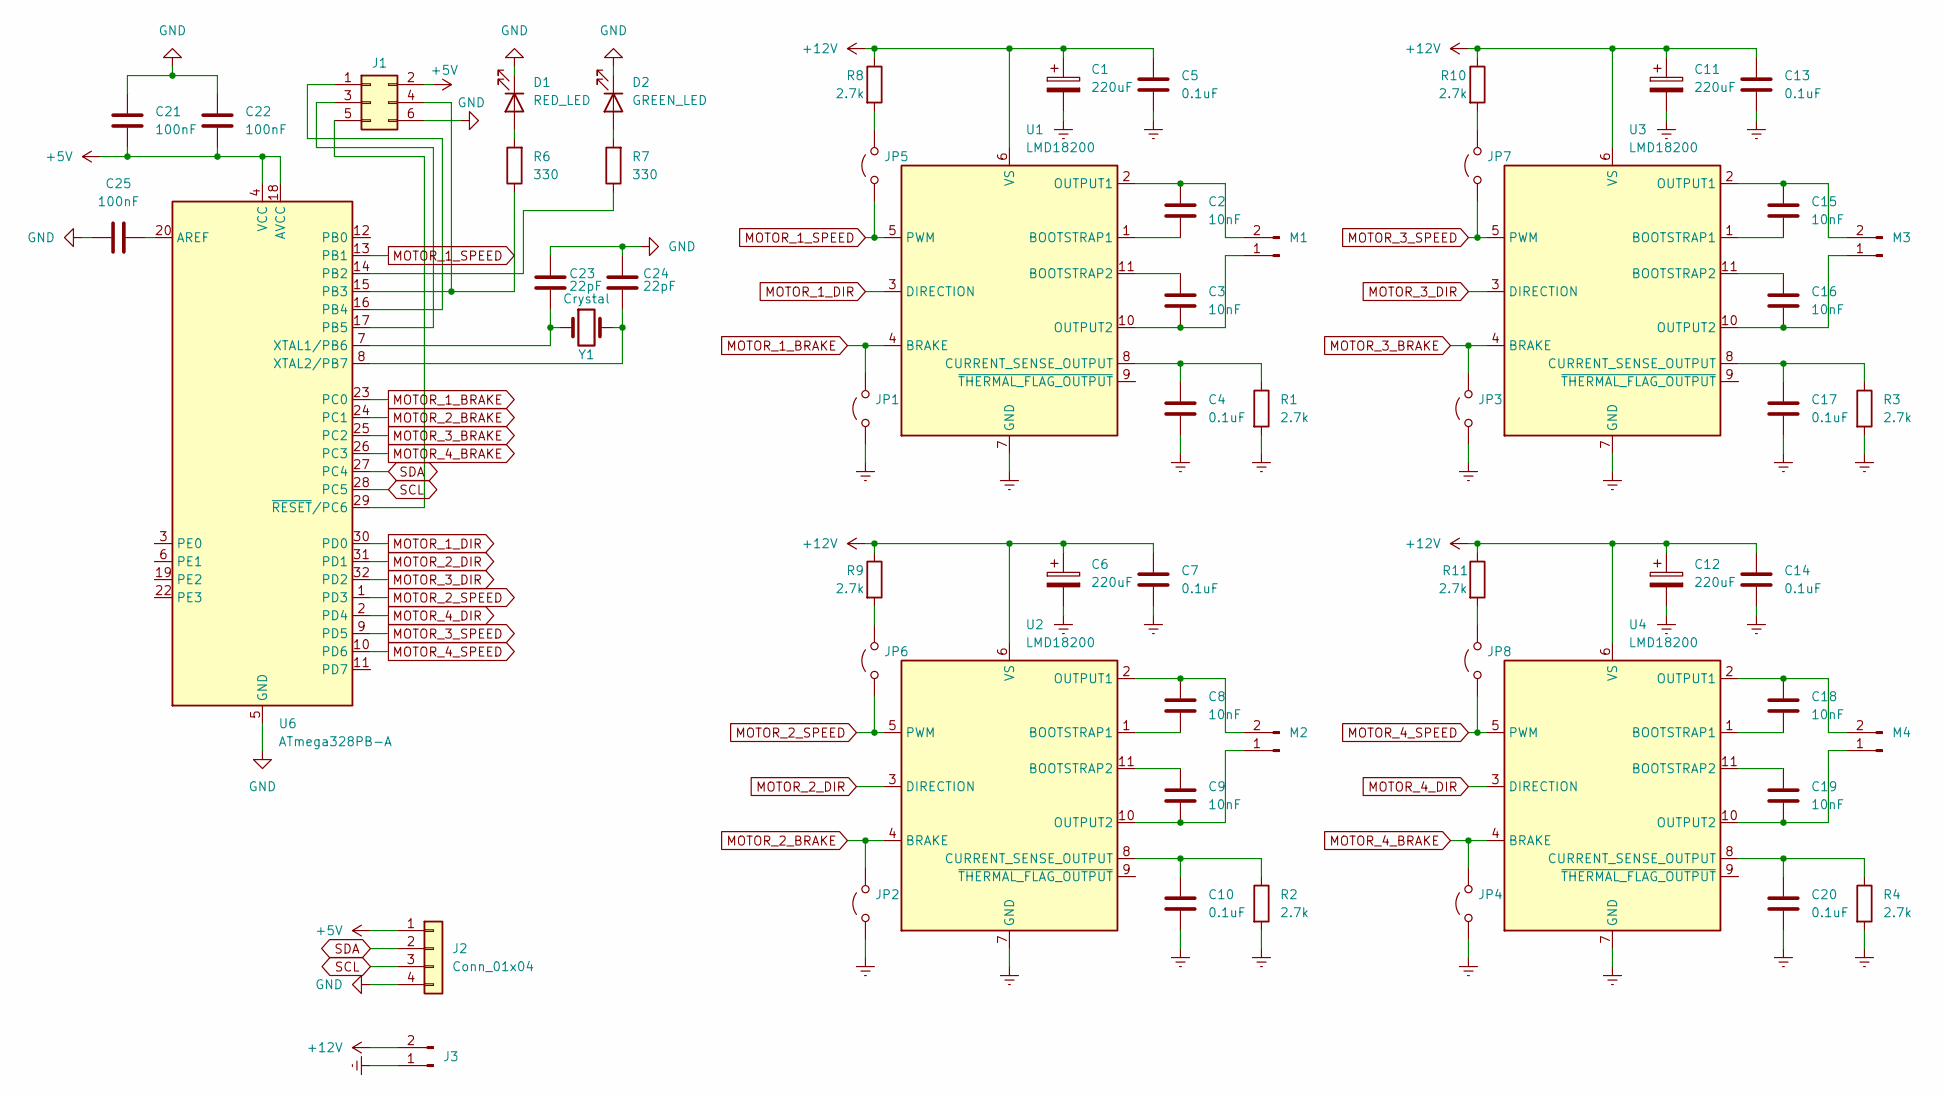
[picture p9: schematic Motor.kicad_sch]

Parts:
C1, C6, C11, C12: 220uF; CP_Elec_10x10
C2, C3, C8, C9, C15, C16, C18, C19: 10nF; C_1210_3225Metric_Pad1.33x2.70mm_HandSolder
C4, C5, C7, C10, C13, C14, C17, C20: 0.1uF; C_0805_2012Metric_Pad1.18x1.45mm_HandSolder
C21, C22, C25: 100nF; C_0805_2012Metric_Pad1.18x1.45mm_HandSolder
C23, C24: 22pF; C_0805_2012Metric_Pad1.18x1.45mm_HandSolder
D1: RED_LED; LED_0805_2012Metric_Pad1.15x1.40mm_HandSolder
D2: GREEN_LED; LED_0805_2012Metric_Pad1.15x1.40mm_HandSolder
J1: Conn_02x03_Odd_Even; IDC-Header_2x03_P2.54mm_Vertical_SMD
J2: Conn_01x04; JST_PH_B4B-PH-K_1x04_P2.00mm_Vertical
J3: Conn_01x02_Pin; Molex_KK-254_AE-6410-02A_1x02_P2.54mm_Vertical
JP1, JP2, JP3, JP4, JP5, JP6, JP7, JP8: Jumper_2_Open; TestPoint_2Pads_Pitch2.54mm_Drill0.8mm
M1, M2, M3, M4: Conn_01x02_Pin; Molex_KK-254_AE-6410-02A_1x02_P2.54mm_Vertical
R1, R2, R3, R4, R8, R9, R10, R11: 2.7k; R_0805_2012Metric_Pad1.20x1.40mm_HandSolder
R6, R7: 330; R_0805_2012Metric_Pad1.20x1.40mm_HandSolder
U1, U2, U3, U4: LMD18200; TO-220-11_P3.4x5.08mm_StaggerOdd_Lead4.85mm_Vertical
U6: ATmega328PB-A; TQFP-32_7x7mm_P0.8mm
Y1: Crystal; Crystal_SMD_HC49-SD

Connections:
+5V: C21.2, C22.2, J1.2, J2.1, U6.4 (VCC), U6.18 (AVCC)
+12V: C1.1, C5.1, C6.1, C7.1, C11.1, C12.1, C13.1, C14.1, J3.2, R8.1, R9.1, R10.1, R11.1, U1.6 (VS), U2.6 (VS), U3.6 (VS), U4.6 (VS)
Earth: C1.2, C4.2, C5.2, C6.2, C7.2, C10.2, C11.2, C12.2, C13.2, C14.2, C17.2, C20.2, J3.1, JP1.1 (A), JP2.1 (A), JP3.1 (A), JP4.1 (A), R1.2, R2.2, R3.2, R4.2, U1.7 (GND), U2.7 (GND), U3.7 (GND), U4.7 (GND)
GND: C21.1, C22.1, C23.1, C24.1, C25.2, D1.1 (K), D2.1 (K), J1.6, J2.4, U6.5 (GND), U6.21 (GND)
MOTOR_1_BRAKE: JP1.2 (B), U1.4 (BRAKE), U6.23 (PC0)
MOTOR_1_DIR: U1.3 (DIRECTION), U6.30 (PD0)
MOTOR_1_SPEED: JP5.1 (A), U1.5 (PWM), U6.13 (PB1)
MOTOR_2_BRAKE: JP2.2 (B), U2.4 (BRAKE), U6.24 (PC1)
MOTOR_2_DIR: U2.3 (DIRECTION), U6.31 (PD1)
MOTOR_2_SPEED: JP6.1 (A), U2.5 (PWM), U6.1 (PD3)
MOTOR_3_BRAKE: JP3.2 (B), U3.4 (BRAKE), U6.25 (PC2)
MOTOR_3_DIR: U3.3 (DIRECTION), U6.32 (PD2)
MOTOR_3_SPEED: JP7.1 (A), U3.5 (PWM), U6.9 (PD5)
MOTOR_4_BRAKE: JP4.2 (B), U4.4 (BRAKE), U6.26 (PC3)
MOTOR_4_DIR: U4.3 (DIRECTION), U6.2 (PD4)
MOTOR_4_SPEED: JP8.1 (A), U4.5 (PWM), U6.10 (PD6)
unnamed: D1.2 (A), R6.2
unnamed: D2.2 (A), R7.2
unnamed: J1.1, U6.16 (PB4)
unnamed: J1.3, U6.17 (PB5)
unnamed: J1.4, R6.1, U6.15 (PB3)
unnamed: J1.5, U6.29 (~RESET/PC6)
unnamed: JP5.2 (B), R8.2
unnamed: JP6.2 (B), R9.2
unnamed: JP7.2 (B), R10.2
unnamed: JP8.2 (B), R11.2
unnamed: C3.2, M1.1, U1.10 (OUTPUT2)
unnamed: C2.1, M1.2, U1.2 (OUTPUT1)
unnamed: C9.2, M2.1, U2.10 (OUTPUT2)
unnamed: C8.1, M2.2, U2.2 (OUTPUT1)
unnamed: C16.2, M3.1, U3.10 (OUTPUT2)
unnamed: C15.1, M3.2, U3.2 (OUTPUT1)
unnamed: C19.2, M4.1, U4.10 (OUTPUT2)
unnamed: C18.1, M4.2, U4.2 (OUTPUT1)
unnamed: C2.2, U1.1 (BOOTSTRAP1)
unnamed: C3.1, U1.11 (BOOTSTRAP2)
unnamed: C4.1, R1.1, U1.8 (CURRENT_SENSE_OUTPUT)
unnamed: C8.2, U2.1 (BOOTSTRAP1)
unnamed: C9.1, U2.11 (BOOTSTRAP2)
unnamed: C10.1, R2.1, U2.8 (CURRENT_SENSE_OUTPUT)
unnamed: C15.2, U3.1 (BOOTSTRAP1)
unnamed: C16.1, U3.11 (BOOTSTRAP2)
unnamed: C17.1, R3.1, U3.8 (CURRENT_SENSE_OUTPUT)
unnamed: C18.2, U4.1 (BOOTSTRAP1)
unnamed: C19.1, U4.11 (BOOTSTRAP2)
unnamed: C20.1, R4.1, U4.8 (CURRENT_SENSE_OUTPUT)
unnamed: C25.1, U6.20 (AREF)
unnamed: R7.1, U6.14 (PB2)
unnamed: C23.2, U6.7 (XTAL1/PB6), Y1.1
unnamed: C24.2, U6.8 (XTAL2/PB7), Y1.2
SCL: J2.3, U6.28 (PC5)
SDA: J2.2, U6.27 (PC4)

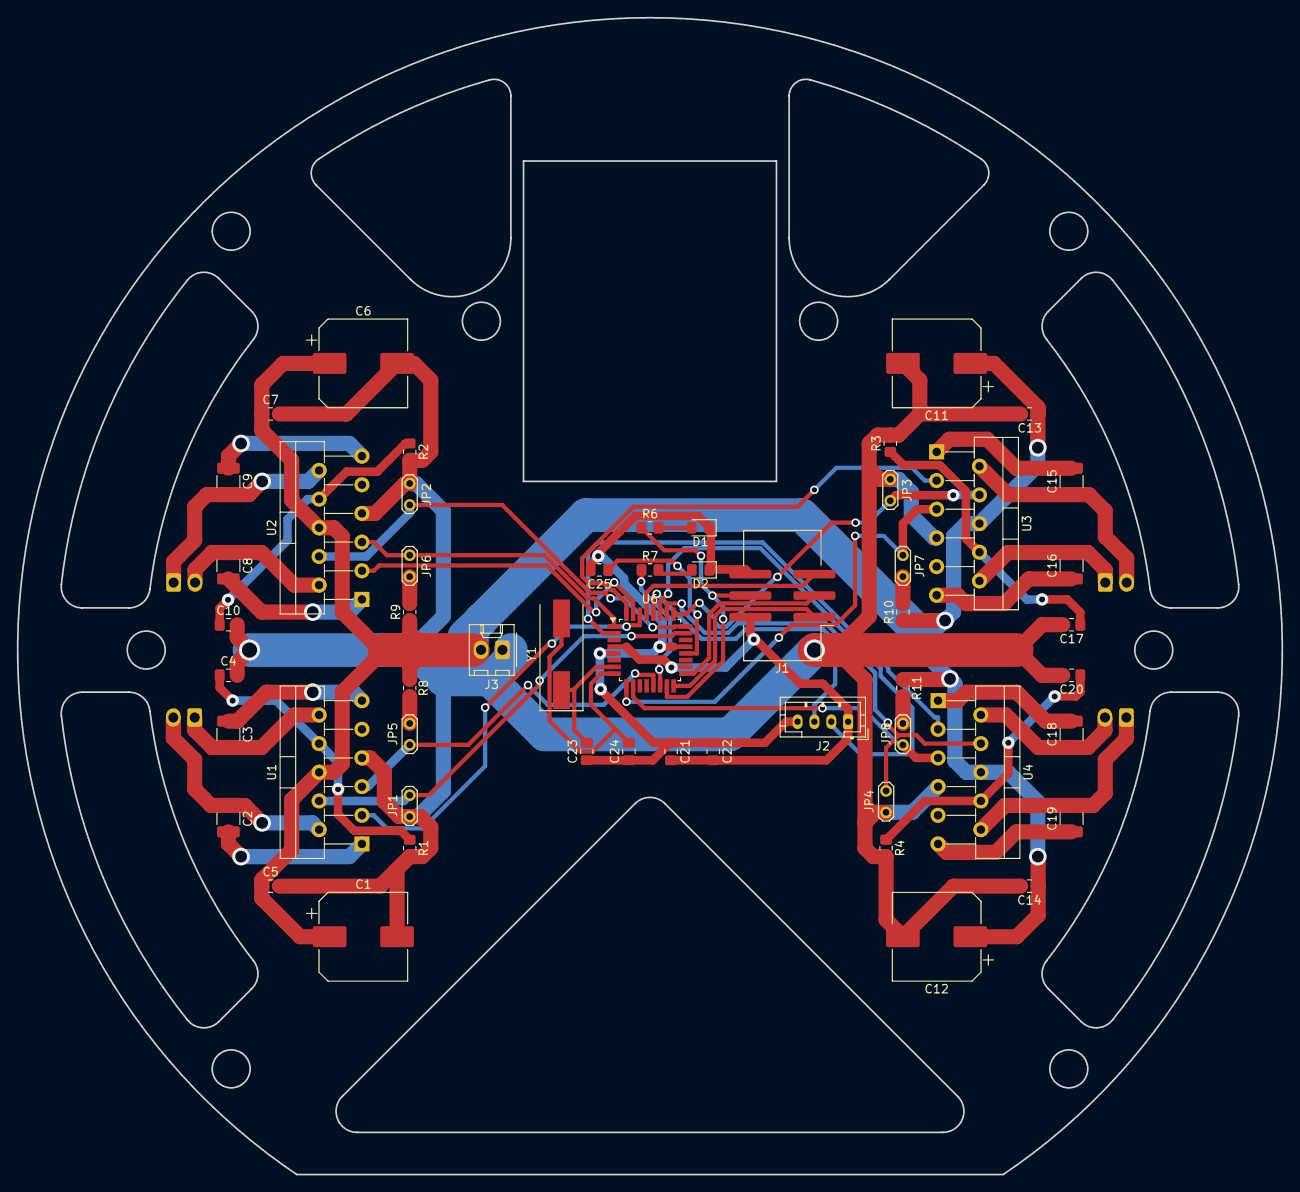
[picture p10: board Motor.kicad_pcb from above]

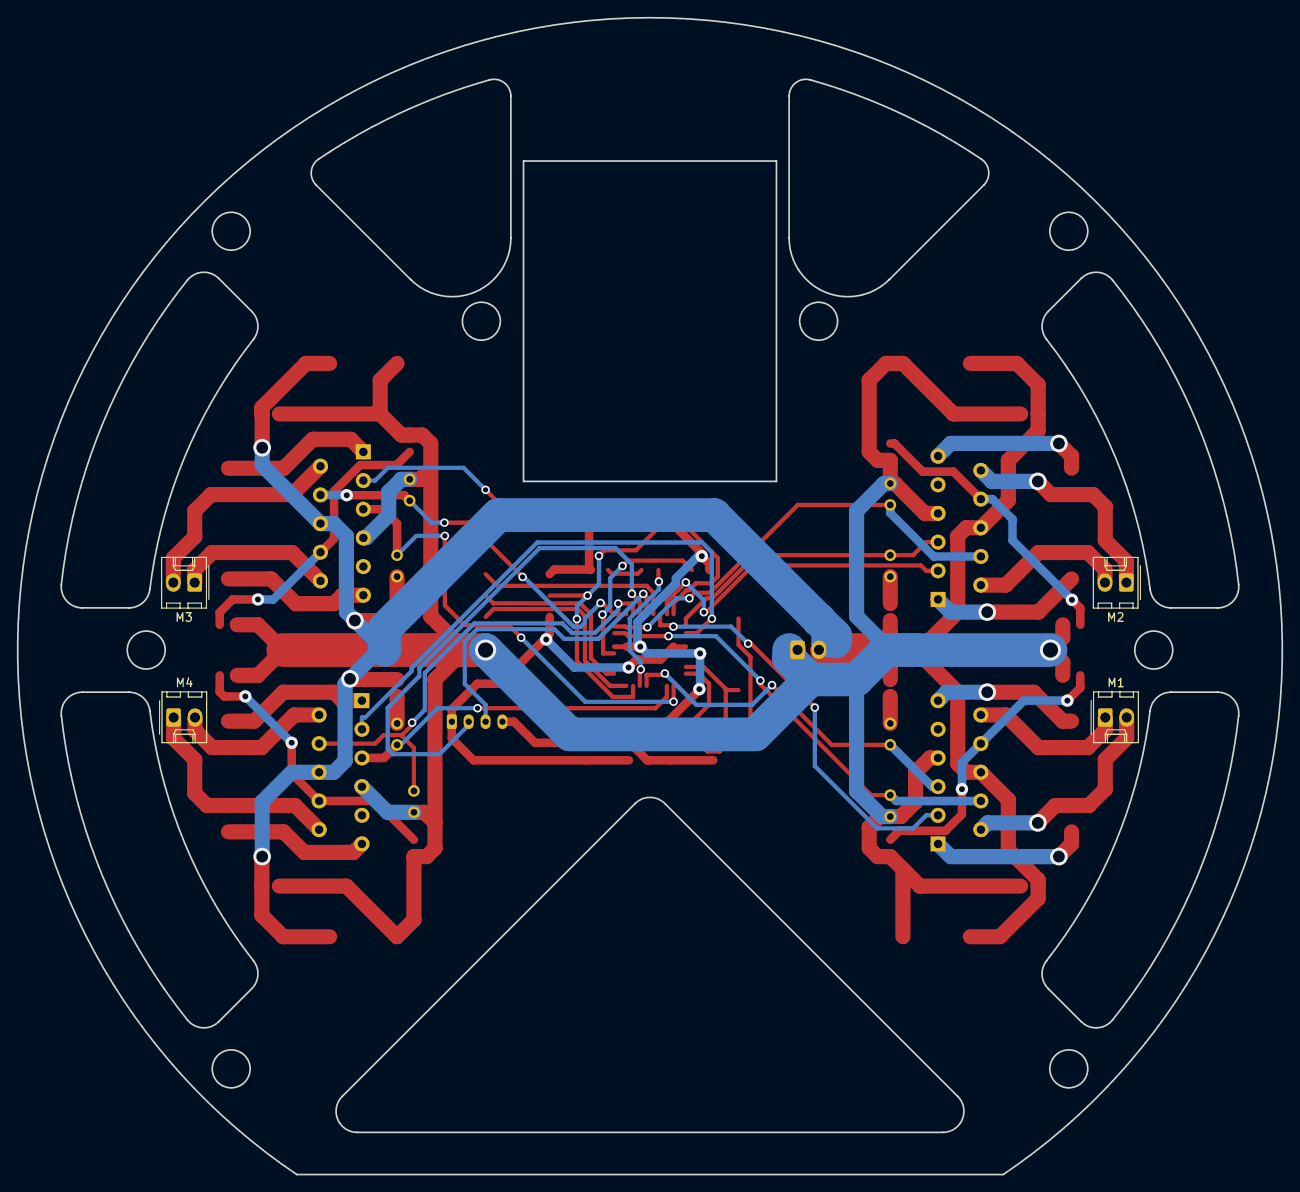
[picture p11: board Motor.kicad_pcb from below]

Board: 2 copper layers, 150.0 x 137.2 mm, 58 parts (4 on the bottom side), 52 nets.
