marc-cr1810/SoccBot/Software/Arduino/SoccBot/SoccIR/SoccIR.ino

#include <Wire.h>
#include <robot.h>

#include "tssp_cluster.h"

#define THRESHOLD	120

robot_state_t state(11, 10);

analog_multi_t tssp_cluster_1(PIN_PC0, PIN_PD0, PIN_PD1, PIN_PD2);
analog_multi_t tssp_cluster_2(PIN_PC1, PIN_PD3, PIN_PD4, PIN_PD5);
analog_multi_t tssp_cluster_3(PIN_PC2, PIN_PD6, PIN_PD7, PIN_PB0);

tssp_cluster_t light_clusters[TSSP_COUNT - 1];

bool has_ball = false;
uint16_t angle = 0;
uint32_t tssps = 0;

void setup()
{
	state.set_state(robot_state_t::booted);

	Wire.begin(IR_I2C_ADDRESS);
	Wire.onRequest(i2c_request_event);
	Wire.onReceive(i2c_recieve_event);

	delay(100);
	state.set_state(robot_state_t::standby);
}

uint16_t read_ir_sensor(uint8_t index)
{
	uint8_t cluster_index = floor((float)index / 8.0f);
	analog_multi_t* cluster = nullptr;
	switch (cluster_index)
	{
	case 0: cluster = &tssp_cluster_1; break;
	case 1: cluster = &tssp_cluster_2; break;
	case 2: cluster = &tssp_cluster_3; break;
	default: state.set_state(robot_state_t::error); return 0;
	}

	uint8_t cluster_tssp_index = index - (cluster_index * 8);
	if (cluster_tssp_index > 0b111)
	{
		state.set_state(robot_state_t::error);
		return 0;
	}
	return cluster->read(cluster_tssp_index);
}

void loop()
{
	state.update();

	int count = 0;
	int8_t min = -1;
	int8_t max = -1;
	uint32_t values = 0;
	bool is_cluster = false;

	for (ssize_t i = 0; i < TSSP_COUNT; i++)
	{
		bool value = read_ir_sensor(i) < THRESHOLD;
		values |= (uint32_t)(value ? 1 : 0) << (23 - i);

		if (is_cluster)
		{
			if (!value)
			{
				max = i - 1;
				light_clusters[count].set_min(min);
				light_clusters[count].set_max(max);
				count++;
				min = -1;
				max = -1;
				is_cluster = false;
			}
			else if (i == (TSSP_COUNT - 1))
			{
				max = i;
				if (count > 0 && light_clusters[0].get_min() == 0)
				{
					light_clusters[0].set_min(min);
					min = -1;
					max = -1;
					is_cluster = false;
				}
				else
				{
					max = i - 1;
					light_clusters[count].set_min(min);
					light_clusters[count].set_max(max);
					count++;
					min = -1;
					max = -1;
					is_cluster = false;
				}
			}
		}
		else if (value)
		{
			min = i;
			if (i == (TSSP_COUNT - 1))
			{
				light_clusters[0].set_min(min);
				min = -1;
				max = -1;
				is_cluster = false;
			}
			else
			{
				is_cluster = true;
			}
		}
	}

	if (count > 0)
	{
		tssp_cluster_t& cluster = light_clusters[0];
		for (int i = 1; i < count; i++)
		{
			if (light_clusters[i].count() > cluster.count())
			{
				cluster = light_clusters[i];
			}
		}
		angle = round(cluster.angle() * 100);
	}
	else
	{
		angle = 0;
	}
	tssps = values;
	has_ball = count > 0;
}

void i2c_request_event()
{
	Wire.write((uint8_t)((angle >> 8) & 0xFF));
	Wire.write((uint8_t)(angle & 0xFF));
	Wire.write((uint8_t)has_ball);
	Wire.write((uint8_t)(tssps >> 16) & 0xFF);
	Wire.write((uint8_t)(tssps >> 8)  & 0xFF);
	Wire.write((uint8_t)tssps & 0xFF);
}

void i2c_recieve_event(int bytes)
{
}
