marc-cr1810/SoccBot/(commit log)

2024-06-22 Initial files
    [Motor.kicad_pcb, Motor.kicad_sch, Robot-Motor_Board.dxf, Robot-Upper_Plate.3mf, Robot.FCStd]
2024-06-25 Lower and upper plates, light sensor and motor PCBs, lower shroud and invalid sketch for upper shroud
    [Motor.kicad_pcb, Motor.kicad_sch, Robot-Motor_Board.dxf, Robot-Upper_Plate.3mf, Robot.FCStd, SoccBot.FCStd]
2024-06-28 Upper shrould and PCB. Start to the motor mounts
    [SoccBot.FCStd]
2024-07-06 Prototype 1
    [Battery Shroud.3mf, Camera Board Plate.3mf, Camera Mount.3mf, Camera PCB.3mf, Light Sensor PCB.3mf, Lower Plate.3mf, Lower Shroud.3mf, Main PCB.3mf]
2024-07-06 Fix for the Main PCB on prototype 1
    [Main PCB.3mf, SoccBot.FCStd]
2024-07-06 Shrank the sizes for the upper and lower plates, removed unnecessary screws
    [Camera Plate Mount.3mf, Motor Mount.3mf, SoccBot.FCStd]
2024-07-14 Prototype V2
    [Battery Holder.3mf, Battery Shroud.3mf, Camera Board Plate.3mf, Camera Mount.3mf, Camera PCB.3mf, LED Recv Shroud.3mf, LED Shroud.3mf, Light Sensor PCB.3mf]
2024-08-15 Updated CAD design and PCB's
    [Battery Holder.3mf, Battery Shroud.3mf, Camera Board Plate.3mf, Camera Mount.3mf, Camera PCB.3mf, Camera Plate Mount.3mf, LED Recv Shroud.3mf, LED Shroud.3mf]
2024-08-15 New PCB and CAD designs
    [Camera.kicad_pcb, Camera.kicad_sch, Lightsensor.kicad_pcb, Lightsensor.kicad_sch, Lightsensor_Sensors.kicad_sch, Main (Teensy).kicad_pcb, Main (Teensy).kicad_sch, Motor.kicad_pcb]
2024-08-25 Base library software code and some minor fixes to CAD designs
    [Camera.kicad_pcb, Lightsensor.kicad_pcb]
2024-08-25 Added LED array along with digital and analog multiplexer hardware
2024-08-26 Battery XT60 was reversed
    [Main (Teensy).kicad_pcb, Main (Teensy).kicad_sch]
2024-08-29 I2C Communication
2024-09-04 IR sensor clusters and ball angle, basic light sensor * light sensor threshold needs tweaking
